Robles-C/FPrime-Robot/img/bot.jpg

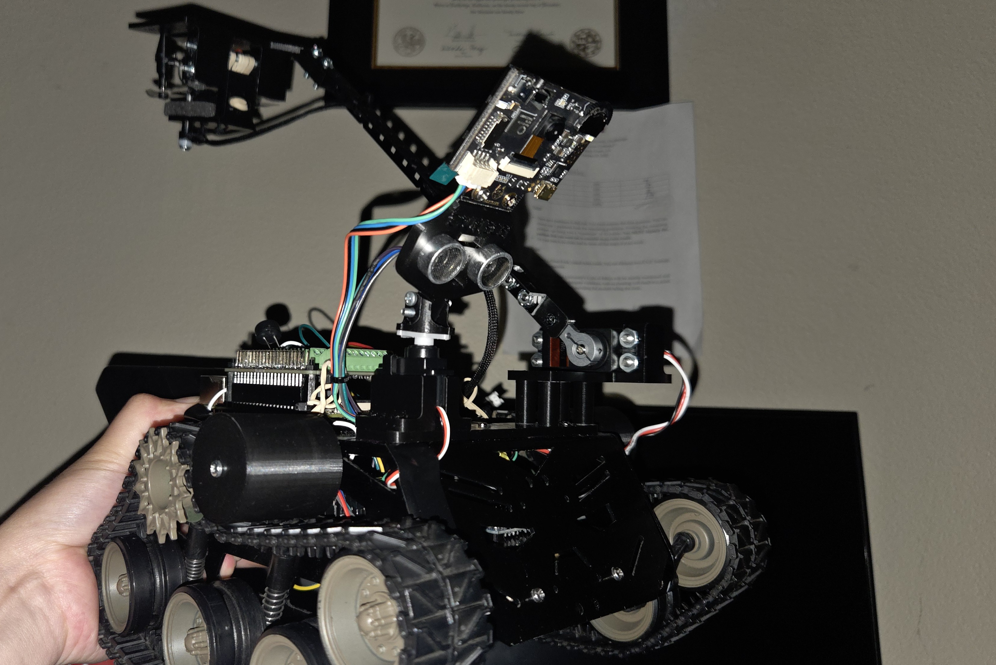
img/bot.jpg
