Robles-C/FPrime-Robot/img/drone.jpg

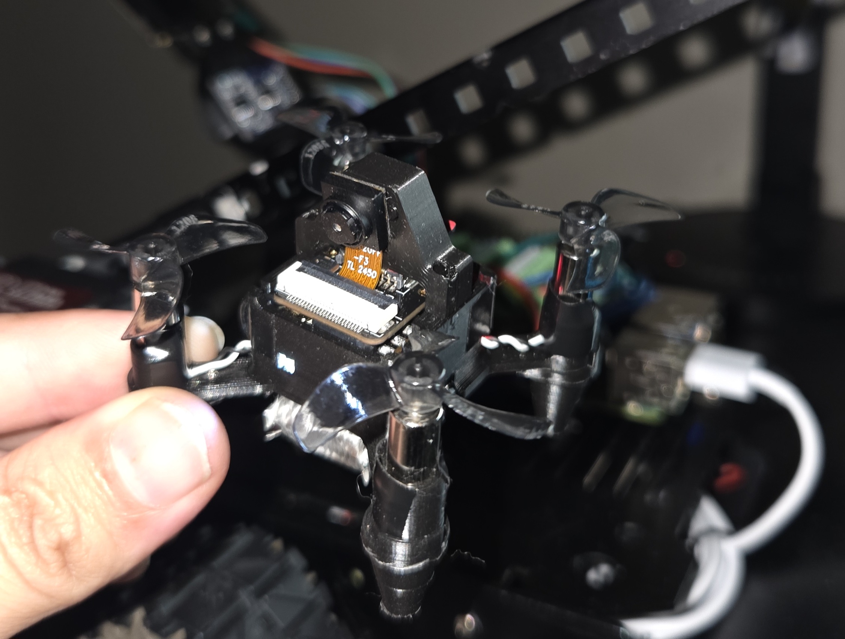
img/drone.jpg
