Robles-C/FPrime-Robot/img/tank1.jpg

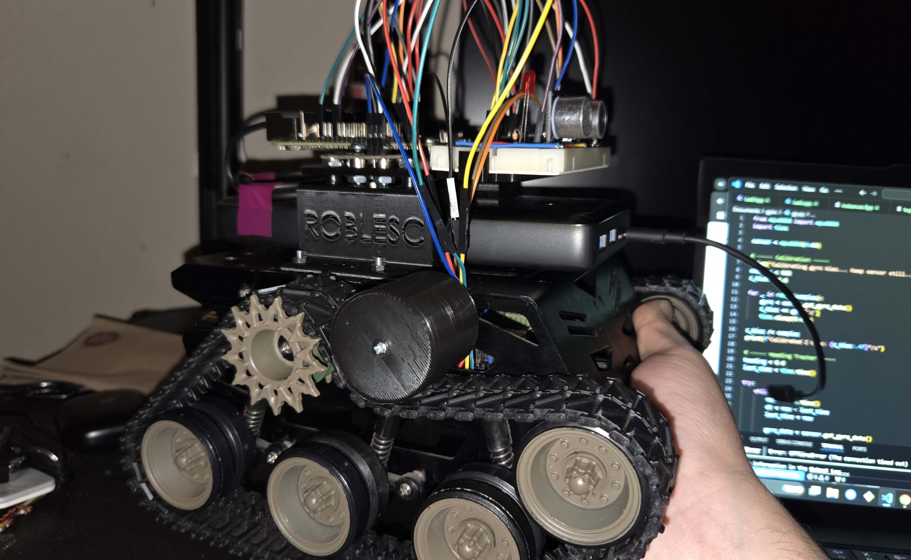
img/tank1.jpg
