Robles-C/FPrime-Robot/Components/proximityGuard/docs/sdd.md

# Components::proximityGuard

ultrasonic sensor detects distances. It halts motion and flashes LED when robot is on a collision course

## Usage Examples
Add usage examples here

### Diagrams
Add diagrams here

### Typical Usage
And the typical usage of the component here

## Class Diagram
Add a class diagram here

## Port Descriptions
| Name | Description |
|---|---|
|---|---|

## Component States
Add component states in the chart below
| Name | Description |
|---|---|
|---|---|

## Sequence Diagrams
Add sequence diagrams here

## Parameters
| Name | Description |
|---|---|
|---|---|

## Commands
| Name | Description |
|---|---|
|---|---|

## Events
| Name | Description |
|---|---|
|---|---|

## Telemetry
| Name | Description |
|---|---|
|---|---|

## Unit Tests
Add unit test descriptions in the chart below
| Name | Description | Output | Coverage |
|---|---|---|---|
|---|---|---|---|

## Requirements
Add requirements in the chart below
| Name | Description | Validation |
|---|---|---|
|---|---|---|

## Change Log
| Date | Description |
|---|---|
|---| Initial Draft |
