Robles-C/FPrime-Robot/test/README.md

# Test Code for Onboard Devices

Includes PCA9685, Freenove ESP32 Wrover, Ultrasonic HC-SR04, HuskyLens Vision Sensor, GY-6050, Servos, Xiao ESP32S3
