Robles-C/FPrime-Robot/Tank1/Top/Tank1TopologyDefs.hpp

// ======================================================================
// \title  Tank1TopologyDefs.hpp
// \brief required header file containing the required definitions for the topology autocoder
//
// ======================================================================
#ifndef TANK1_TANK1TOPOLOGYDEFS_HPP
#define TANK1_TANK1TOPOLOGYDEFS_HPP

#include "Drv/BlockDriver/BlockDriver.hpp"
#include "Fw/Types/MallocAllocator.hpp"
#include "Tank1/Top/FppConstantsAc.hpp"
#include "Svc/FramingProtocol/FprimeProtocol.hpp"
#include "Svc/Health/Health.hpp"

// Definitions are placed within a namespace named after the deployment
namespace Tank1 {

/**
 * \brief required type definition to carry state
 *
 * The topology autocoder requires an object that carries state with the name `Tank1::TopologyState`. Only the type
 * definition is required by the autocoder and the contents of this object are otherwise opaque to the autocoder. The contents are entirely up
 * to the definition of the project. Here, they are derived from command line inputs.
 */
struct TopologyState {
    const CHAR* hostname;
    U16 port;
};

/**
 * \brief required ping constants
 *
 * The topology autocoder requires a WARN and FATAL constant definition for each component that supports the health-ping
 * interface. These are expressed as enum constants placed in a namespace named for the component instance. These
 * are all placed in the PingEntries namespace.
 *
 * Each constant specifies how many missed pings are allowed before a WARNING_HI/FATAL event is triggered. In the
 * following example, the health component will emit a WARNING_HI event if the component instance cmdDisp does not
 * respond for 3 pings and will FATAL if responses are not received after a total of 5 pings.
 *
 * ```c++
 * namespace PingEntries {
 * namespace cmdDisp {
 *     enum { WARN = 3, FATAL = 5 };
 * }
 * }
 * ```
 */
namespace PingEntries {
namespace Tank1_blockDrv {
enum { WARN = 3, FATAL = 5 };
}
namespace Tank1_tlmSend {
enum { WARN = 3, FATAL = 5 };
}
namespace Tank1_cmdDisp {
enum { WARN = 3, FATAL = 5 };
}
namespace Tank1_cmdSeq {
enum { WARN = 3, FATAL = 5 };
}
namespace Tank1_eventLogger {
enum { WARN = 3, FATAL = 5 };
}
namespace Tank1_fileDownlink {
enum { WARN = 3, FATAL = 5 };
}
namespace Tank1_fileManager {
enum { WARN = 3, FATAL = 5 };
}
namespace Tank1_fileUplink {
enum { WARN = 3, FATAL = 5 };
}
namespace Tank1_prmDb {
enum { WARN = 3, FATAL = 5 };
}
namespace Tank1_rateGroup1 {
enum { WARN = 3, FATAL = 5 };
}
namespace Tank1_rateGroup2 {
enum { WARN = 3, FATAL = 5 };
}
namespace Tank1_rateGroup3 {
enum { WARN = 3, FATAL = 5 };
}
}  // namespace PingEntries
}  // namespace Tank1
#endif
