Robles-C/FPrime-Robot/(commit log)

2025-04-01 working motor control, added ultrasonic and ACE components
2025-04-01 Updated motordriver to take 16 bit value for direction/speed control
2025-04-03 Implemented PID Controller
